leslier7/scopeboy/README.md

# scopeboy
Polished version of the ScopeBoy project started in ECE5730
