leslier7/scopeboy/board/RP2350_QFN80.step

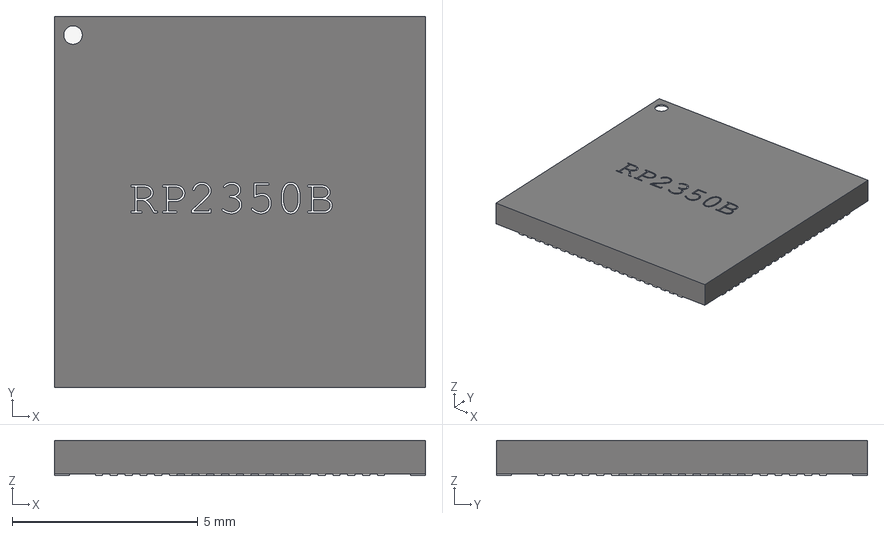
[picture p1: CAD file, 2026-02-20]
board/RP2350_QFN80.step
10.0 x 10.0 x 0.95 mm
