leslier7/scopeboy/board/scopeboy.kicad_pcb

## KiCad design board/scopeboy.kicad_pcb (2026-05-14)

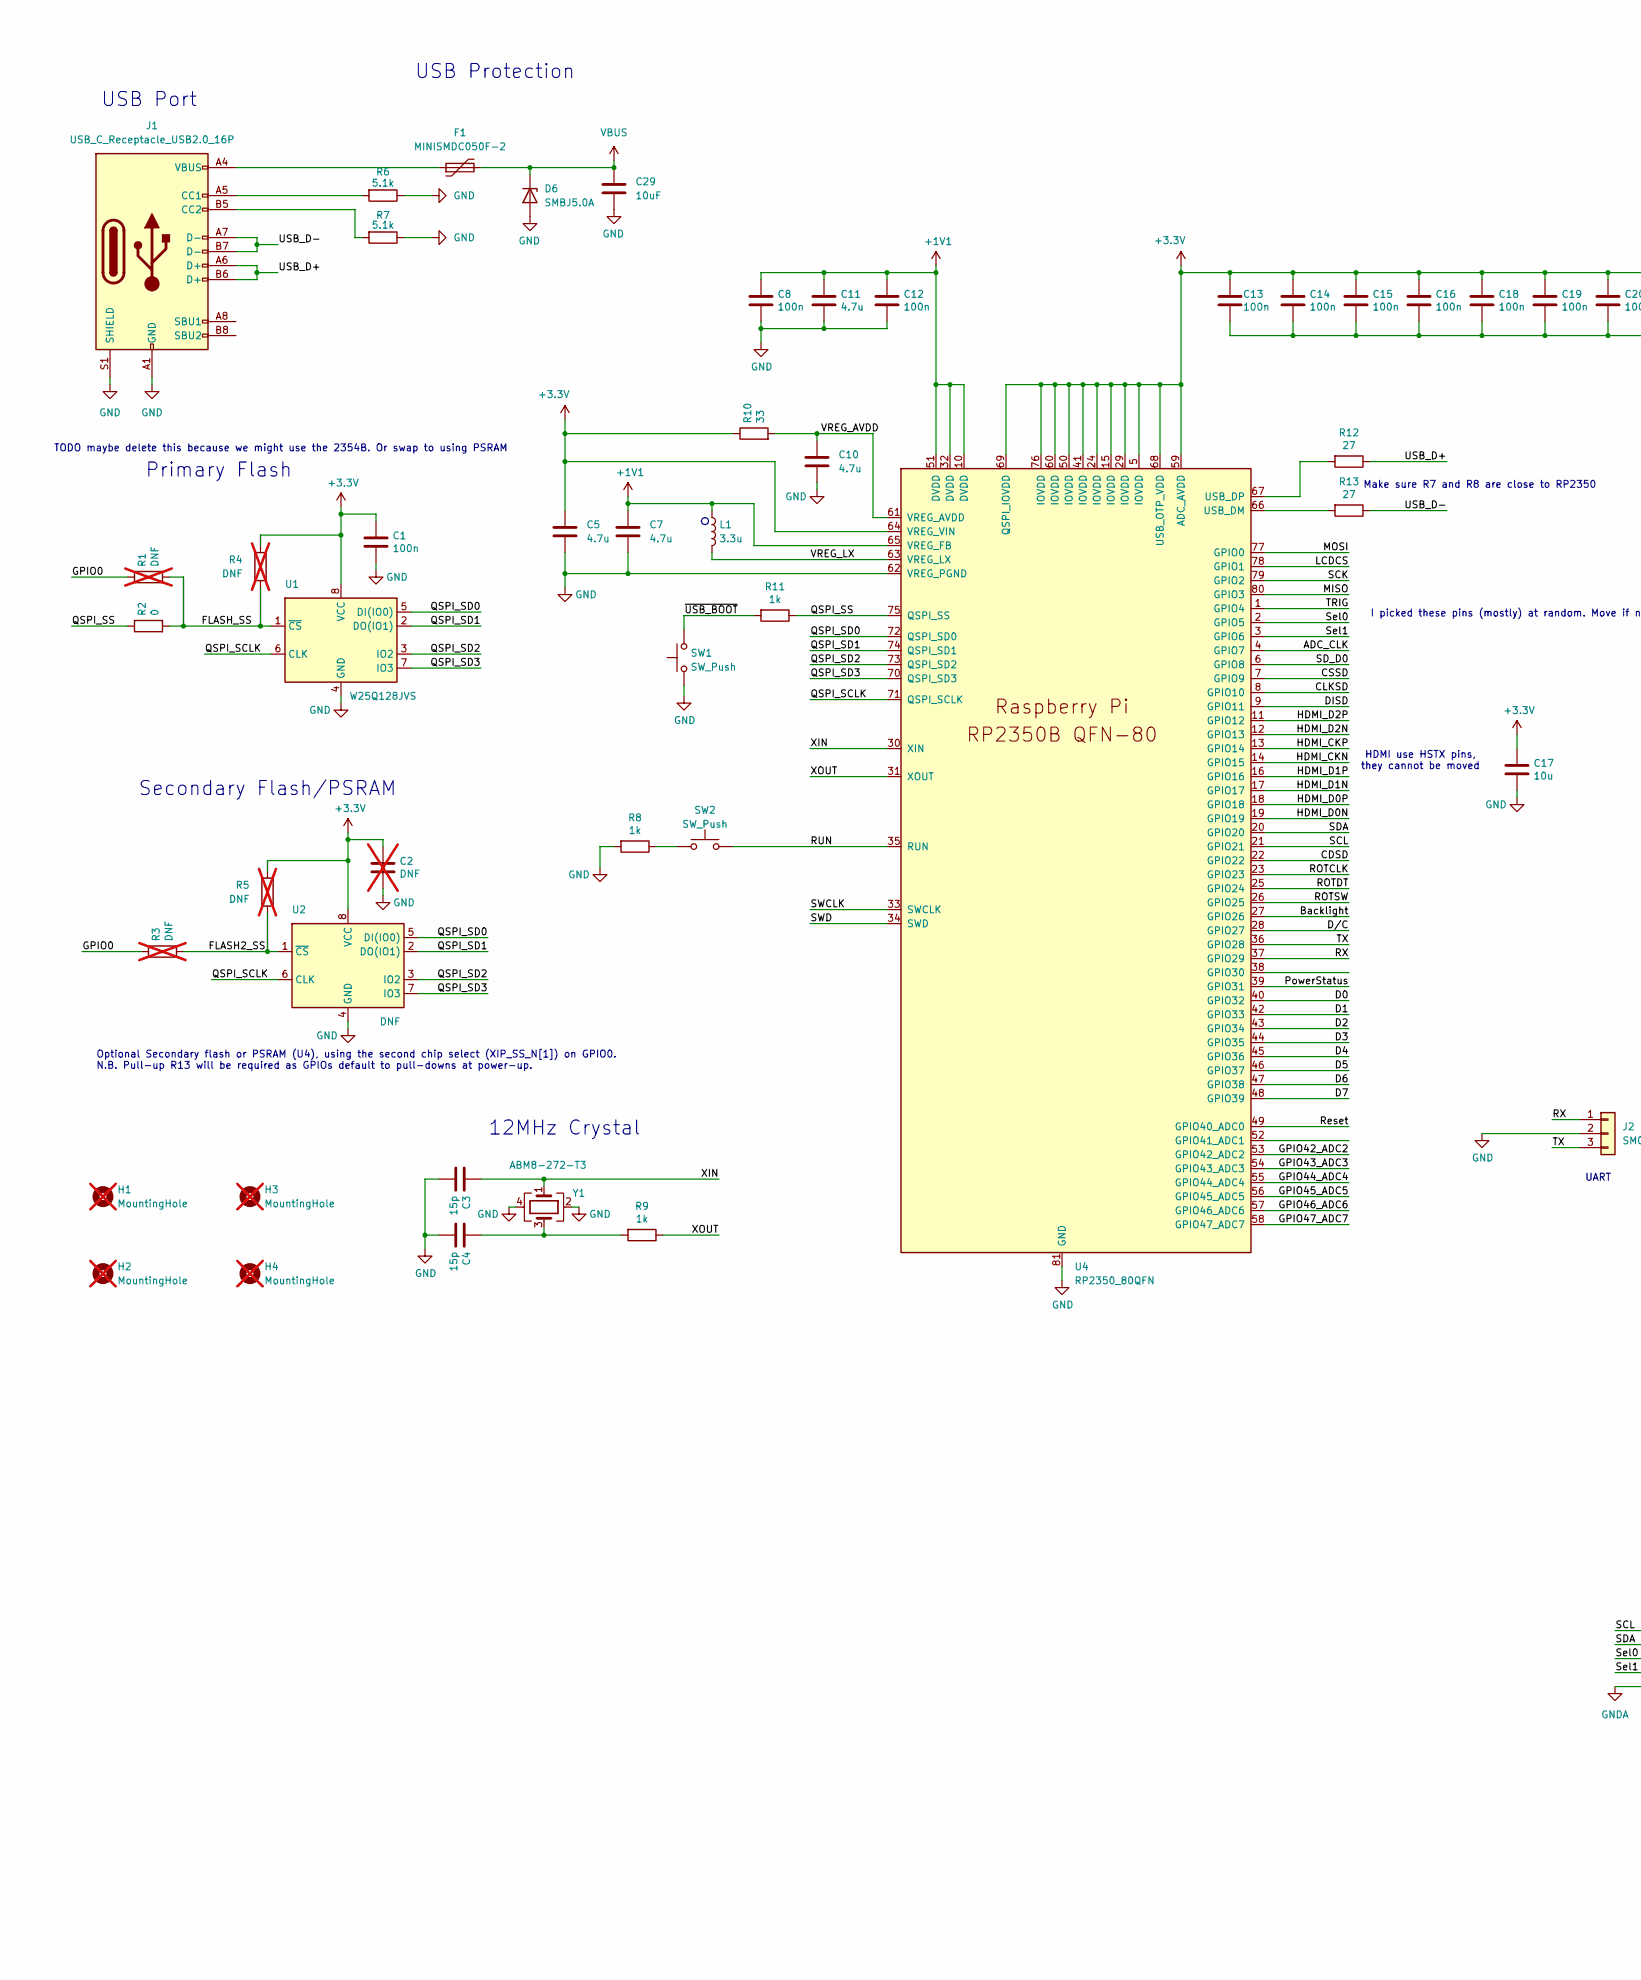
[picture p2: schematic scopeboy.kicad_sch, part in row 1, column 1]

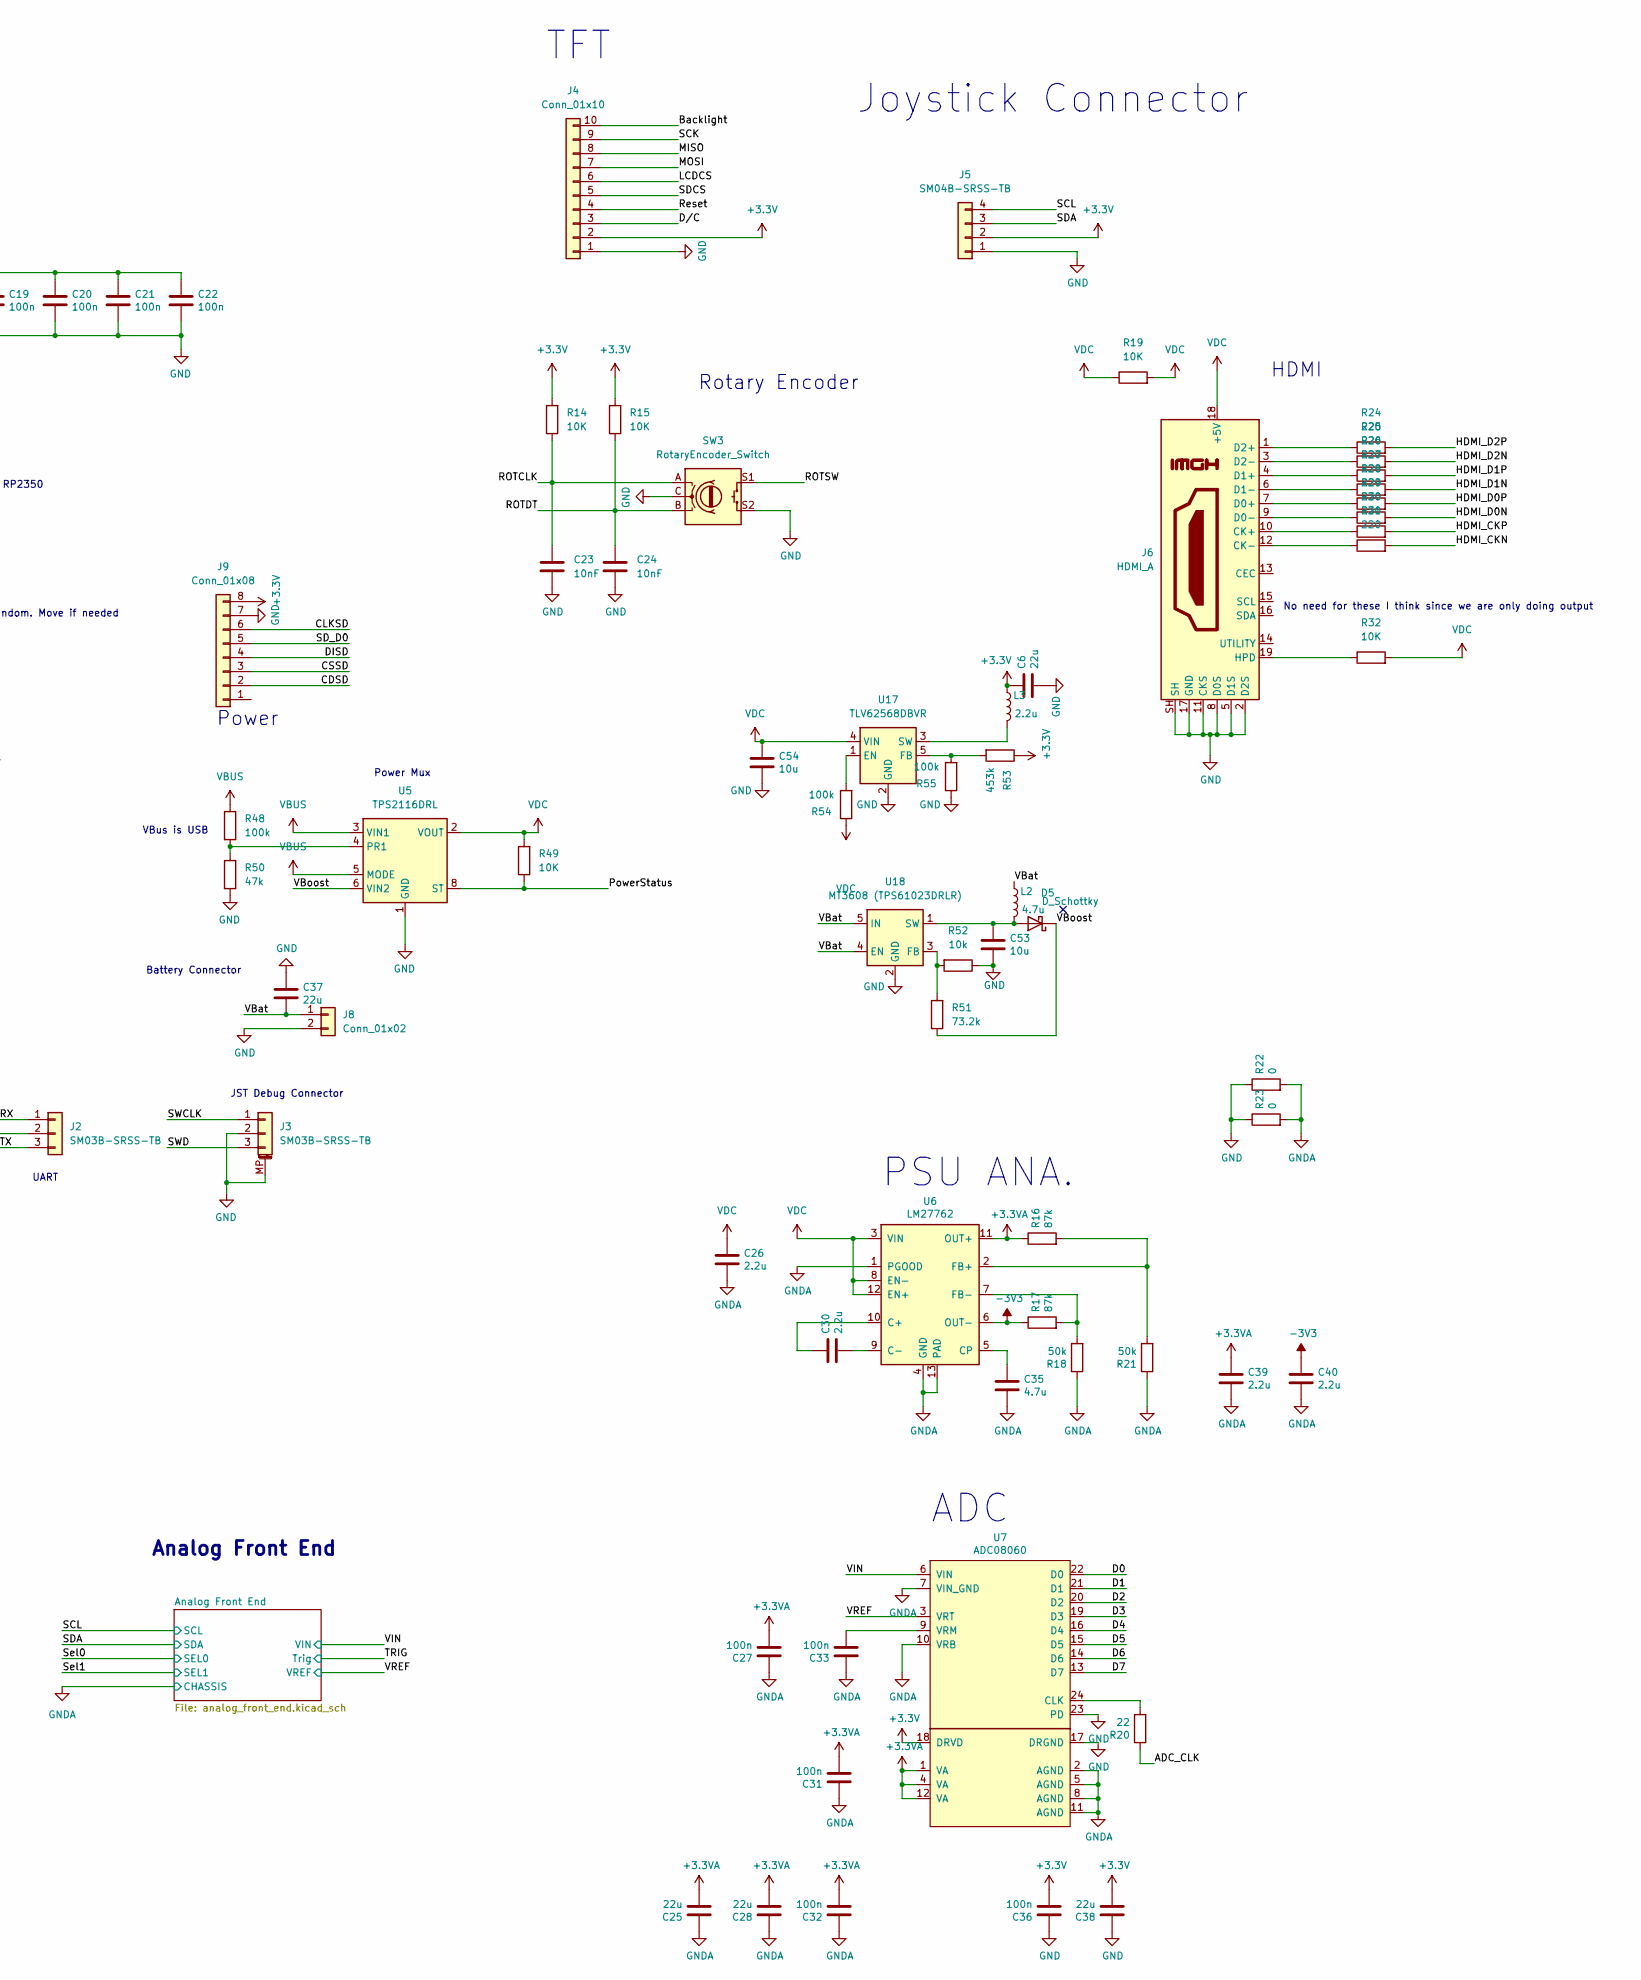
[picture p3: schematic scopeboy.kicad_sch, part in row 1, column 2]

Parts:
C1, C8, C12, C13, C14, C15, C16, C18, C19, C20, C21, C22: 100n; C_0402_1005Metric; MFR. Part # AC0402JRNPO9BN100
C2: DNF; C_0402_1005Metric; not fitted
C3, C4: 15p; C_0402_1005Metric; MFR. Part # GJM1555C1H150GB01D
C5, C7: 4.7u; C_0402_1005Metric_small_pads; MFR. Part # CL05A475MP5NRNC
C6, C37: 22u; C_0805_2012Metric; MFR. Part # CL21A226MQQNNNE
C10, C11: 4.7u; C_0402_1005Metric; MFR. Part # CL05A475MP5NRNC
C17, C53, C54: 10u; C_0805_2012Metric; MFR. Part # CL21A106KOQNNNE
C23, C24: 10nF; C_0603_1608Metric; MFR. Part # CL10B103KB8NNNC; LCSC Part # C1589
C25, C28, C38: 22u; C_0603_1608Metric; MFR. Part # CL10A226MQ8NRNC; LCSC Part # C59461
C26, C30, C39, C40: 2.2u; C_0603_1608Metric; MFR. Part # CL10A225KO8NNNC; LCSC Part # C23630
C27, C31, C32, C33, C36: 100n; C_0603_1608Metric; MFR. Part # CC0603KRX7R9BB104; LCSC Part # C14663
C29: 10uF; C_1206_3216Metric; MFR. Part # TMK316BJ106KL-T
C35: 4.7u; C_0603_1608Metric; MFR. Part # CL10A475KO8NNNC; LCSC Part # C19666
D5: D_Schottky; D_SMA; MFR. Part # SS14
D6: SMBJ5.0A; D_SMB; MFR. Part # SMBJ5.0A
F1: MINISMDC050F-2; Fuse_1812_4532Metric; MFR. Part # MINISMDC050F-2
H1, H2, H3, H4: MountingHole; MountingHole_3.2mm_M3_Pad_TopBottom; not fitted
J1: USB_C_Receptacle_USB2.0_16P; USB_C_Receptacle_GCT_USB4105-xx-A_16P_TopMnt_Horizontal; MFR. Part # USB4105-GF-A
J2: SM03B-SRSS-TB; JST_SH_SM03B-SRSS-TB_1x03-1MP_P1.00mm_Horizontal; MFR. Part # SM03B-SRSS-TB(LF)(SN); LCSC Part # C160403
J3: SM03B-SRSS-TB; JST_SH_SM03B-SRSS-TB_1x03-1MP_P1.00mm_Horizontal
J4: Conn_01x10; PinHeader_1x10_P2.54mm_Vertical
J5: SM04B-SRSS-TB; JST_SH_SM04B-SRSS-TB_1x04-1MP_P1.00mm_Horizontal; MFR. Part # SM04B-SRSS-TB(LF)(SN); LCSC Part # C160404
J6: HDMI_A; HDMI_A_Molex_208658-1001_Horizontal; MFR. Part # 2086581001
J8: Conn_01x02; JST_PH_S2B-PH-SM4-TB_1x02-1MP_P2.00mm_Horizontal; MFR. Part # S2B-PH-SM4-TB(LF)(SN)
J9: Conn_01x08; PinHeader_1x08_P2.54mm_Vertical
L1: 3.3u; L_pol_2016; MFR. Part # SRN4018TA-3R3M
L2: 4.7u; L_Bourns-SRN4018; MFR. Part # SRN4018TA-4R7M
L3: 2.2u; L_Bourns-SRN4018; MFR. Part # SRN4018-2R2M
R1, R3, R4, R5: DNF; R_0402_1005Metric; not fitted
R2: 0; R_0402_1005Metric; MFR. Part # RC0402JR-070RL
R6, R7: 5.1k; R_1206_3216Metric; MFR. Part # CRCW12065K10FKEA
R8, R9, R11: 1k; R_0402_1005Metric; MFR. Part # CRCW04021K00FKED
R10: 33; R_0402_1005Metric; MFR. Part # RC0402JR-0733RL
R12, R13: 27; R_0402_1005Metric; MFR. Part # RC0402JR-0727RL
R14, R15, R19, R32, R49: 10K; R_0603_1608Metric; MFR. Part # RC0603FR-0710KL
R16, R17: 87k; R_0603_1608Metric; MFR. Part # 0603WAF8202T5E; LCSC Part # C23254
R18, R21: 50k; R_0603_1608Metric; MFR. Part # 0603WAF1503T5E; LCSC Part # C22807
R20: 22; R_0603_1608Metric; MFR. Part # 0603WAF220JT5E; LCSC Part # C23345
R22, R23: 0; R_0603_1608Metric; MFR. Part # 0603WAF0000T5E; LCSC Part # C21189
R24, R25, R26, R27, R28, R29, R30, R31: 220; R_0603_1608Metric; MFR. Part # CRGCQ0603J220R
R48, R54, R55: 100k; R_0603_1608Metric; MFR. Part # RC0603FR-07100KL
R50: 47k; R_0603_1608Metric; MFR. Part # RC0603FR-0747KL
R51: 73.2k; R_0603_1608Metric; MFR. Part # RMCF0603FT73K2
R52: 10k; R_0603_1608Metric; MFR. Part # RC0603FR-0710KL
R53: 453k; R_0603_1608Metric; MFR. Part # CRCW0603453KFKEAC
SW1, SW2: SW_Push; SW_Push_1P1T_NO_Vertical_Wuerth_434133025816
SW3: RotaryEncoder_Switch; PEC11L4115FS0020; MFR. Part # PEC11L4115FS0020
U1: W25Q128JVS; SOIC-8_5.23x5.23mm_P1.27mm; MFR. Part # W25Q128JVS
U2: DNF; SOIC-8_5.23x5.23mm_P1.27mm
U4: RP2350_80QFN; RP2350-QFN-80-1EP_10x10_P0.4mm_EP3.4x3.4mm_ThermalVias; MFR. Part # RP2354B
U5: TPS2116DRL; SOT-583-8; MFR. Part # TPS2116DRLR
U6: LM27762; WSON-12-1EP_3x2mm_P0.5mm_EP1x2.65_ThermalVias; MFR. Part # LM27762DSSR; LCSC Part # C473398
U7: ADC08060; TSSOP-24_4.4x7.8mm_P0.65mm; MFR. Part # TI ADC08060CIMT/NOPB; LCSC Part # C701069
U17: TLV62568DBVR; SOT-23-5; MFR. Part # TLV62568DBVR
U18: MT3608 (TPS61023DRLR); SOT-23-6; MFR. Part # MT3608
Y1: ABM8-272-T3; Crystal_SMD_3225-4Pin_3.2x2.5mm; MFR. Part # ABM8-272-T3

Connections:
+1V1: C7.1, C8.1, C11.1, C12.1, L1.1, U4.10 (DVDD), U4.32 (DVDD), U4.51 (DVDD), U4.65 (VREG_FB)
+3.3V: C1.1, C2.1, C5.1, C6.1, C13.1, C14.1, C15.1, C16.1, C17.1, C18.1, C19.1, C20.1, C21.1, C22.1, C36.2, C38.2, J4.2, J5.2, J9.8, L3.1, R4.1, R5.1, R10.1, R14.2, R15.2, R53.1, U1.8 (VCC), U2.8 (VCC), U4.5 (IOVDD), U4.15 (IOVDD), U4.24 (IOVDD), U4.29 (IOVDD), U4.41 (IOVDD), U4.50 (IOVDD), U4.59 (ADC_AVDD), U4.60 (IOVDD), U4.64 (VREG_VIN), U4.68 (USB_OTP_VDD), U4.69 (QSPI_IOVDD), U4.76 (IOVDD), U7.18 (DRVD)
+3.3VA: C25.2, C27.2, C28.2, C31.2, C32.2, C39.1, R16.1, U6.11 (OUT+), U7.1 (VA), U7.4 (VA), U7.12 (VA); also elsewhere on the board
-3V3: C40.1, R17.1, U6.6 (OUT-); also elsewhere on the board
/ADC_CLK: R20.1, U4.4 (GPIO7)
/Backlight: J4.10, U4.27 (GPIO26)
/CDSD: J9.2, U4.22 (GPIO22)
/CLKSD: J9.6, U4.8 (GPIO10)
/CSSD: J9.3, U4.7 (GPIO9)
/D0: U4.40 (GPIO32), U7.22 (D0)
/D1: U4.42 (GPIO33), U7.21 (D1)
/D2: U4.43 (GPIO34), U7.20 (D2)
/D3: U4.44 (GPIO35), U7.19 (D3)
/D4: U4.45 (GPIO36), U7.16 (D4)
/D5: U4.46 (GPIO37), U7.15 (D5)
/D6: U4.47 (GPIO38), U7.14 (D6)
/D7: U4.48 (GPIO39), U7.13 (D7)
/DISD: J9.4, U4.9 (GPIO11)
/D/C: J4.3, U4.28 (GPIO27)
/FLASH2_SS: R3.2, R5.2, U2.1 (~CS)
/FLASH_SS: R1.2, R2.2, R4.2, U1.1 (~CS)
/GPIO0: R1.1, R3.1
/GPIO42_ADC2: U4.53 (GPIO42_ADC2)
/GPIO43_ADC3: U4.54 (GPIO43_ADC3)
/GPIO44_ADC4: U4.55 (GPIO44_ADC4)
/GPIO45_ADC5: U4.56 (GPIO45_ADC5)
/GPIO46_ADC6: U4.57 (GPIO46_ADC6)
/GPIO47_ADC7: U4.58 (GPIO47_ADC7)
/HDMI_CKN: R31.2, U4.14 (GPIO15)
/HDMI_CKP: R30.2, U4.13 (GPIO14)
/HDMI_D0N: R29.2, U4.19 (GPIO19)
/HDMI_D0P: R28.2, U4.18 (GPIO18)
/HDMI_D1N: R27.2, U4.17 (GPIO17)
/HDMI_D1P: R26.2, U4.16 (GPIO16)
/HDMI_D2N: R25.2, U4.12 (GPIO13)
/HDMI_D2P: R24.2, U4.11 (GPIO12)
/LCDCS: J4.6, U4.78 (GPIO1)
/MISO: J4.8, U4.80 (GPIO3)
/MOSI: J4.7, U4.77 (GPIO0)
/PowerStatus: R49.1, U4.39 (GPIO31), U5.8 (ST)
/QSPI_SCLK: U1.6 (CLK), U2.6 (CLK), U4.71 (QSPI_SCLK)
/QSPI_SD0: U1.5 (DI(IO0)), U2.5 (DI(IO0)), U4.72 (QSPI_SD0)
/QSPI_SD1: U1.2 (DO(IO1)), U2.2 (DO(IO1)), U4.74 (QSPI_SD1)
/QSPI_SD2: U1.3 (IO2), U2.3 (IO2), U4.73 (QSPI_SD2)
/QSPI_SD3: U1.7 (IO3), U2.7 (IO3), U4.70 (QSPI_SD3)
/QSPI_SS: R2.1, R11.1, U4.75 (QSPI_SS)
/ROTCLK: C23.1, R14.1, SW3.A, U4.23 (GPIO23)
/ROTDT: C24.1, R15.1, SW3.B, U4.25 (GPIO24)
/ROTSW: SW3.S1, U4.26 (GPIO25)
/RUN: SW2.2, U4.35 (RUN)
/RX: J2.1, U4.37 (GPIO29)
/Reset: J4.4, U4.49 (GPIO40_ADC0)
/SCK: J4.9, U4.79 (GPIO2)
/SCL: J5.4, U4.21 (GPIO21); also elsewhere on the board
/SDA: J5.3, U4.20 (GPIO20); also elsewhere on the board
/SDCS: J4.5
/SD_D0: J9.5, U4.6 (GPIO8)
/SWCLK: J3.1, U4.33 (SWCLK)
/SWD: J3.3, U4.34 (SWD)
/Sel0: U4.2 (GPIO5); also elsewhere on the board
/Sel1: U4.3 (GPIO6); also elsewhere on the board
/TRIG: U4.1 (GPIO4); also elsewhere on the board
/TX: J2.3, U4.36 (GPIO28)
/USB_D+: J1.A6 (D+), J1.B6 (D+), R12.1
/USB_D-: J1.A7 (D-), J1.B7 (D-), R13.1
/VBat: C37.2, J8.1, L2.1, U18.4 (EN), U18.5 (IN)
/VBoost: D5.1 (K), R51.1, U5.6 (VIN2)
/VIN: U7.6 (VIN); also elsewhere on the board
/VREF: U7.3 (VRT); also elsewhere on the board
/VREG_AVDD: C10.1, R10.2, U4.61 (VREG_AVDD)
/VREG_LX: L1.2, U4.63 (VREG_LX)
/XIN: C3.1, U4.30 (XIN), Y1.1
/XOUT: R9.1, U4.31 (XOUT)
/~USB_BOOT: R11.2, SW1.2
GND: C1.2, C2.2, C3.2, C4.2, C5.2, C6.2, C7.2, C8.2, C10.2, C11.2, C12.2, C13.2, C14.2, C15.2, C16.2, C17.2, C18.2, C19.2, C20.2, C21.2, C22.2, C23.2, C24.2, C29.1, C36.1, C37.1, C38.1, C53.2, C54.2, D6.2 (A), J1.A1 (GND), J1.A12 (GND), J1.B1 (GND), J1.B12 (GND), J1.S1 (SHIELD), J2.2, J3.2, J3.MP (MountPin), J4.1, J5.1, J6.2 (D2S), J6.5 (D1S), J6.8 (D0S), J6.11 (CKS), J6.17 (GND), J6.SH, J8.2, J9.7, R6.1, R7.1, R8.2, R22.1, R23.1, R50.2, R52.1, R55.1, SW1.1, SW3.C, SW3.S2, U1.4 (GND), U2.4 (GND), U4.62 (VREG_PGND), U4.81 (GND), U5.1 (GND), U7.17 (DRGND), U7.23 (PD), U17.2 (GND), U18.2 (GND), Y1.2, Y1.4
GNDA: C25.1, C26.2, C27.1, C28.1, C31.1, C32.1, C33.1, C35.2, C39.2, C40.2, R18.1, R21.1, R22.2, R23.2, U6.1 (PGOOD), U6.4 (GND), U6.13 (PAD), U7.2 (AGND), U7.5 (AGND), U7.7 (VIN_GND), U7.8 (AGND), U7.10 (VRB), U7.11 (AGND); also elsewhere on the board
unnamed: C4.1, R9.2, Y1.3
unnamed: C53.1, D5.2 (A), L2.2, U18.1 (SW)
unnamed: F1.1, J1.A4 (VBUS), J1.A9 (VBUS), J1.B4 (VBUS), J1.B9 (VBUS)
unnamed: J1.A5 (CC1), R6.2
unnamed: J1.B5 (CC2), R7.2
unnamed: J6.10 (CK+), R30.1
unnamed: J6.12 (CK-), R31.1
unnamed: J6.7 (D0+), R28.1
unnamed: J6.9 (D0-), R29.1
unnamed: J6.4 (D1+), R26.1
unnamed: J6.6 (D1-), R27.1
unnamed: J6.1 (D2+), R24.1
unnamed: J6.3 (D2-), R25.1
unnamed: J6.19 (HPD), R32.1
unnamed: R8.1, SW2.1
unnamed: R13.2, U4.66 (USB_DM)
unnamed: R12.2, U4.67 (USB_DP)
unnamed: R48.2, R50.1, U5.4 (PR1)
unnamed: C30.1, U6.10 (C+)
unnamed: C30.2, U6.9 (C-)
unnamed: C35.1, U6.5 (CP)
unnamed: R16.2, R21.2, U6.2 (FB+)
unnamed: R17.2, R18.2, U6.7 (FB-)
unnamed: R20.2, U7.24 (CLK)
unnamed: C33.2, U7.9 (VRM)
unnamed: R54.2, U17.1 (EN)
unnamed: R53.2, R55.2, U17.5 (FB)
unnamed: L3.2, U17.3 (SW)
unnamed: R51.2, R52.2, U18.3 (FB)
VBUS: C29.2, D6.1 (K), F1.2, R48.1, U5.3 (VIN1), U5.5 (MODE)
VDC: C26.1, C54.1, J6.18 (+5V), R19.1, R19.2, R32.2, R49.2, R54.1, U5.2 (VOUT), U5.7 (VOUT), U6.3 (VIN), U6.8 (EN-), U6.12 (EN+), U17.4 (VIN)

Notes on the sheet:
Optional Secondary flash or PSRAM (U4), using the second chip select (XIP_SS_N[1]) on GPIO0. N.B. Pull-up R13 will be required as GPIOs default to pull-downs at power-up.
Rotary Encoder
12MHz Crystal
Power Mux
I picked these pins (mostly) at random. Move if needed
ADC
PSU ANA.
Joystick Connector
Primary Flash
USB Protection
Battery Connector
No need for these I think since we are only doing output
TFT
HDMI use HSTX pins, they cannot be moved
JST Debug Connector
Make sure R7 and R8 are close to RP2350
Analog Front End
Secondary Flash/PSRAM
TODO maybe delete this because we might use the 2354B. Or swap to using PSRAM
VBus is USB
UART
USB Port
Power
HDMI

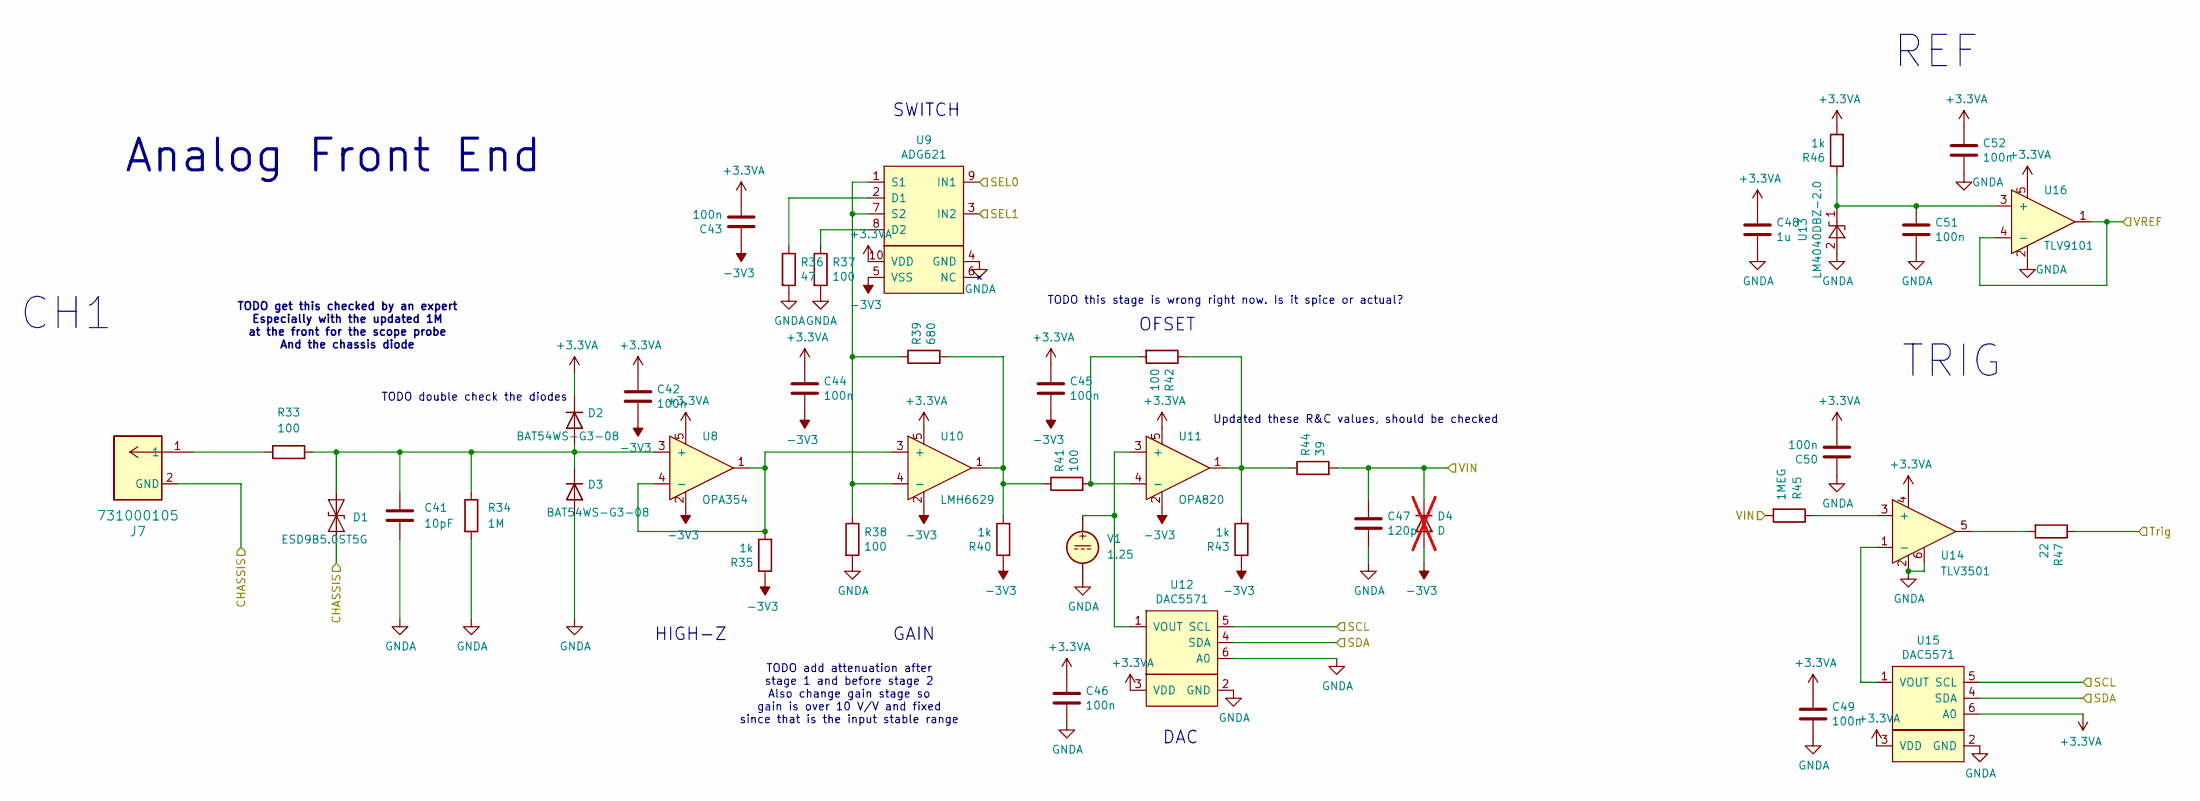
[picture p4: schematic analog_front_end.kicad_sch]

Parts:
C41: 10pF; C_0603_1608Metric; MFR. Part # C0603C100J5GACTU
C42, C43, C44, C45, C46, C49, C50, C51, C52: 100n; C_0603_1608Metric; MFR. Part # CC0603KRX7R9BB104; LCSC Part # C14663
C47: 120p; C_0603_1608Metric; MFR. Part # FN18X104K160PSG
C48: 1u; C_0603_1608Metric; MFR. Part # CL10A105KB8NNNC; LCSC Part # C15849
D1: ESD9B5.0ST5G; D_SOD-923; MFR. Part # ESD9B5.0ST5G
D2, D3: BAT54WS-G3-08; D_0603_1608Metric; MFR. Part # BAT54WS-E3-08
D4: D; D_0603_1608Metric; not fitted
J7: 731000105; CONN_73100-0105_MOL; MFR. Part # 731000105
R33: 100; R_0603_1608Metric; MFR. Part # ERJ-3EKF1000V
R34: 1M; R_0603_1608Metric; MFR. Part # RC0603FR-071ML
R35, R40, R43, R46: 1k; R_0603_1608Metric; MFR. Part # 0603WAF1001T5E; LCSC Part # C21190
R36: 47; R_0603_1608Metric; MFR. Part # 0603WAF470JT5E; LCSC Part # C23182
R37, R38, R41, R42: 100; R_0603_1608Metric; MFR. Part # ERJ-3EKF1000V; LCSC Part # C22775
R39: 680; R_0603_1608Metric; MFR. Part # 0603WAF6801T5E; LCSC Part # C23212
R44: 39; R_0603_1608Metric; MFR. Part # 0603WAF1000T5E
R45: 1MEG; R_0603_1608Metric; MFR. Part # ERJ3EKF1004V; LCSC Part # C193390
R47: 22; R_0603_1608Metric; MFR. Part # 0603WAF220JT5E; LCSC Part # C23345
U8: OPA354; SOT-23-5; MFR. Part # OPA354AIDBVR; LCSC Part # C36384
U9: ADG621; MSOP-10_3x3mm_P0.5mm; MFR. Part # ADG621BRMZ; LCSC Part # C208597
U10: LMH6629; SOT-23-5; MFR. Part # LMH6629MFX/NOPB; LCSC Part # C206003
U11: OPA820; SOT-23-5; MFR. Part # OPA830IDBVR; LCSC Part # C2058414
U12, U15: DAC5571; SOT-23-6; MFR. Part # DAC5571IDBVT; LCSC Part # C24061
U13: LM4040DBZ-2.0; SOT-23; MFR. Part # LM4040A20IDBZR; LCSC Part # C127070
U14: TLV3501; SOT-23-6; MFR. Part # TLV3501AIDBVT; LCSC Part # C193413
U16: TLV9101; SOT-23-5; MFR. Part # TLV9101IDBVR; LCSC Part # C4368903
V1: 1.25

Connections:
+3.3VA: C42.1, C43.2, C44.1, C45.1, C46.1, C48.1, C49.1, C50.2, C52.1, D2.1 (K), R46.2, U8.5, U9.10 (VDD), U10.5, U11.5, U12.3 (VDD), U14.4, U15.3 (VDD), U15.6 (A0), U16.5; also elsewhere on the board
-3V3: C42.2, C43.1, C44.2, C45.2, D4.2 (A), R35.1, R40.1, R43.1, U8.2, U9.5 (VSS), U10.2, U11.2; also elsewhere on the board
/SCL: U12.5 (SCL), U15.5 (SCL); also elsewhere on the board
/SDA: U12.4 (SDA), U15.4 (SDA); also elsewhere on the board
/Sel0: U9.9 (IN1); also elsewhere on the board
/Sel1: U9.3 (IN2); also elsewhere on the board
/TRIG: R47.1; also elsewhere on the board
/VIN: C47.1, D4.1 (K), R44.2, R45.2; also elsewhere on the board
/VREF: U16.1, U16.4 (-); also elsewhere on the board
GNDA: C41.2, C46.2, C47.2, C48.2, C49.2, C50.1, C51.2, C52.2, D1.2 (A2), D3.2 (A), J7.2 (GND), R34.2, R36.2, R37.2, R38.2, U9.4 (GND), U12.2 (GND), U12.6 (A0), U13.2 (A), U14.2, U14.6, U15.2 (GND), U16.2, V1.2; also elsewhere on the board
unnamed: C41.1, D1.1 (A1), D2.2 (A), D3.1 (K), R33.2, R34.1, U8.3 (+)
unnamed: J7.1, R33.1
unnamed: R39.2, R40.2, R41.1, U10.1
unnamed: R42.1, R43.2, R44.1, U11.1
unnamed: R47.2, U14.5
unnamed: R36.1, U9.2 (D1)
unnamed: R37.1, U9.8 (D2)
unnamed: R35.2, U8.1, U8.4 (-), U10.3 (+)
unnamed: R38.1, R39.1, U9.1 (S1), U9.7 (S2), U10.4 (-)
unnamed: U11.3 (+), U12.1 (VOUT), V1.1
unnamed: R41.2, R42.2, U11.4 (-)
unnamed: C51.1, R46.1, U13.1 (K), U16.3 (+)
unnamed: R45.1, U14.3 (+)
unnamed: U14.1 (-), U15.1 (VOUT)

Notes on the sheet:
TODO this stage is wrong right now. Is it spice or actual?
DAC
TODO add attenuation after stage 1 and before stage 2 Also change gain stage so gain is over 10 V/V and fixed since that is the input stable range
GAIN
REF
SWITCH
TODO get this checked by an expert Especially with the updated 1M at the front for the scope probe And the chassis diode
Updated these R&C values, should be checked
HIGH-Z
TODO double check the diodes
TRIG
CH1
OFSET
Analog Front End

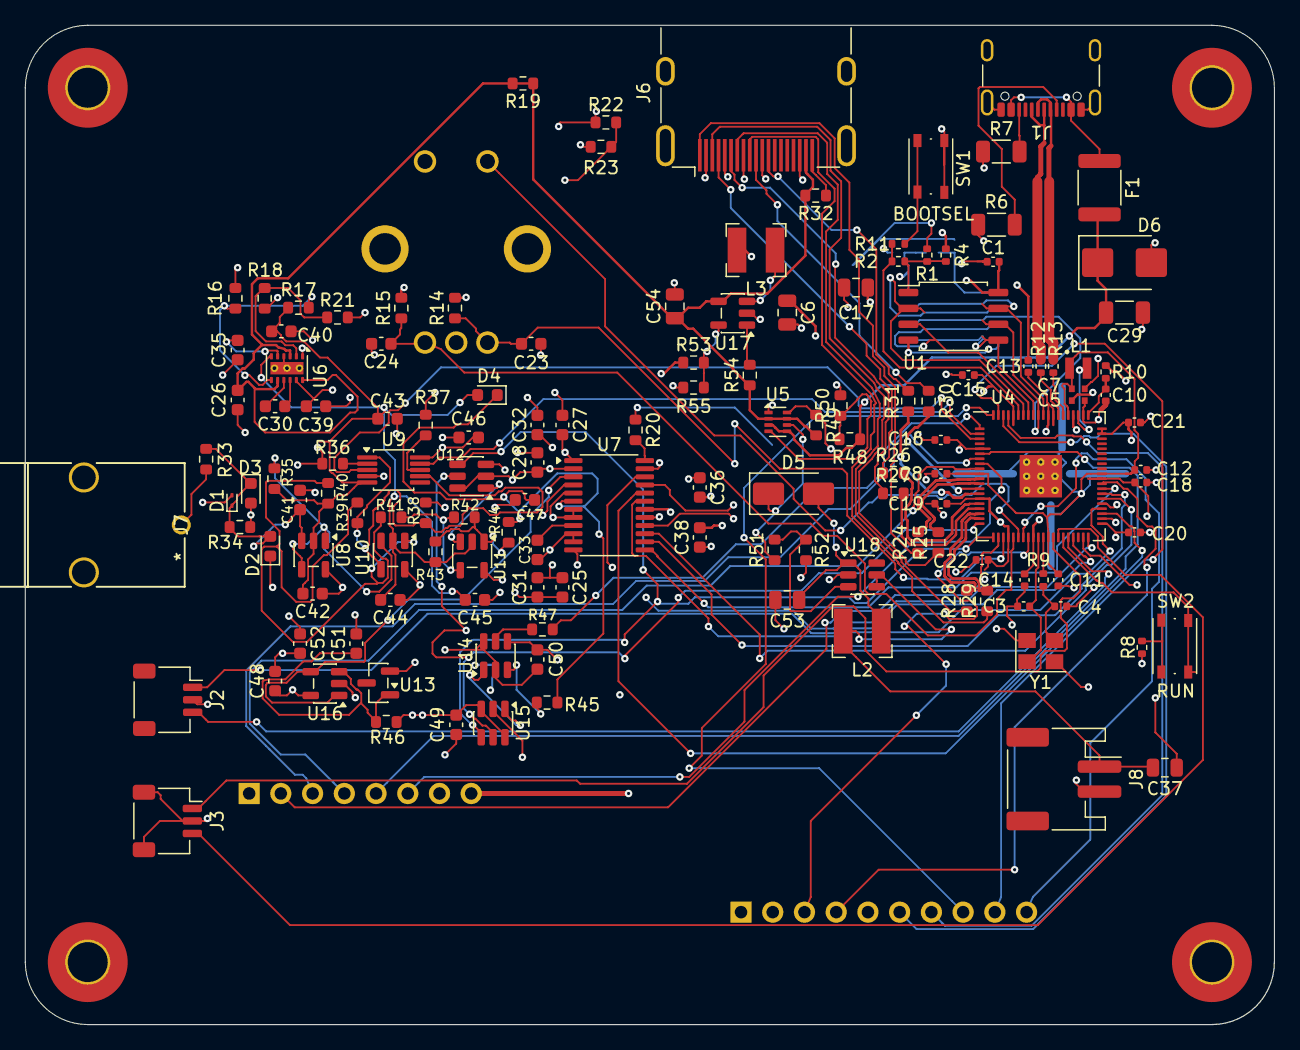
[picture p5: board scopeboy.kicad_pcb from above]

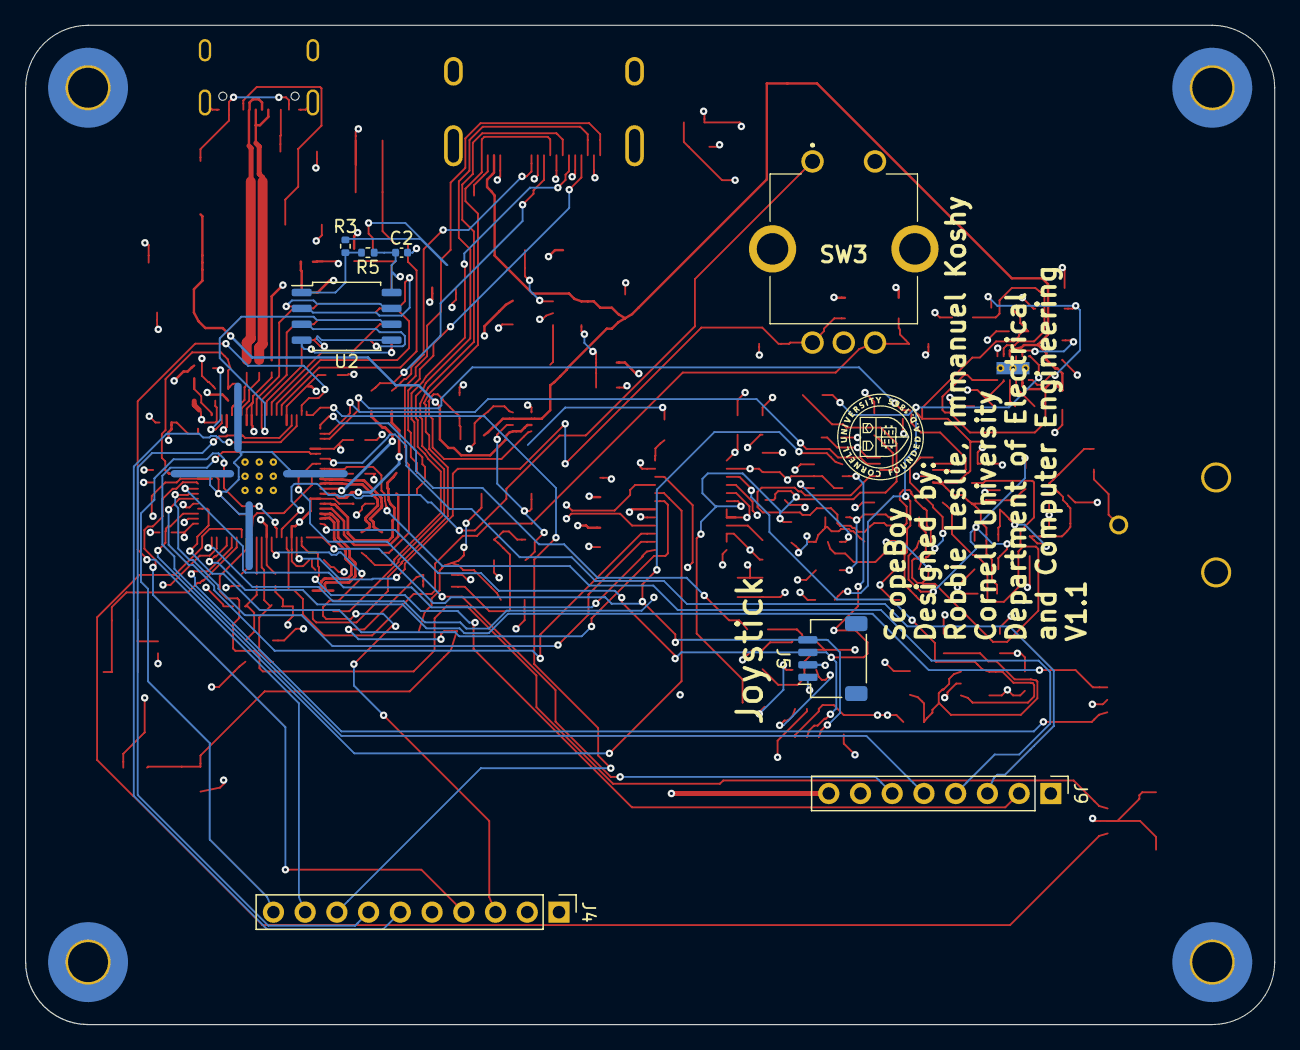
[picture p6: board scopeboy.kicad_pcb from below]

Board: 4 copper layers, 100.0 x 80.0 mm, 151 parts (8 on the bottom side), 114 nets.
