leslier7/scopeboy/(commit log)

2026-02-20 Minimal RP2350B board
    [RP2350_QFN80.step, scopeboy.kicad_pcb, scopeboy.kicad_sch]
2026-02-27 Continued schematic moving from old version to new version
    [scopeboy.kicad_sch]
2026-03-04 Fixed MFR label and added more TOOD
    [scopeboy.kicad_sch]
2026-03-06 More TODO notes and swaped ref op amp
    [scopeboy.kicad_sch]
2026-03-06 Added TODO for 5V charge pump
    [scopeboy.kicad_sch]
2026-03-06 HDMI to HSTX GPIO pins, and more TODOs
    [scopeboy.kicad_sch]
2026-03-13 Added spice circuit models
2026-03-13 Working on simulation for front end
    [analog_front_end.kicad_sch, analog_front_end_sim.kicad_sch, scopeboy.kicad_sch]
2026-03-19 Got first version of front end sim working
    [analog_front_end_sim.kicad_sch, stage_3_sim.kicad_sch]
2026-03-20 More work on front end circuit, and GPIO connections
    [analog_front_end.kicad_sch, analog_front_end_sim.kicad_sch, scopeboy.kicad_sch]
2026-04-17 All components in layout
    [analog_front_end.kicad_sch, scopeboy.kicad_pcb, scopeboy.kicad_sch]
2026-04-17 Positioned boards at same place
    [scopeboy.kicad_pcb]
2026-04-17 Replaced copper with vias
    [scopeboy.kicad_pcb]
2026-04-17 Started placement
    [scopeboy.kicad_pcb]
2026-04-17 New merge placemetn
    [scopeboy.kicad_pcb]
2026-04-17 Updated trig, sel0, sel1 pins
    [scopeboy.kicad_pcb, scopeboy.kicad_sch]
2026-04-17 Added battery JST connector
    [analog_front_end.kicad_sch, scopeboy.kicad_pcb, scopeboy.kicad_sch]
2026-04-19 Added power mux and USB protection
    [analog_front_end.kicad_sch, scopeboy.kicad_pcb, scopeboy.kicad_sch]
2026-04-20 Updated board with new power system
    [scopeboy.kicad_pcb, scopeboy.kicad_sch]
2026-04-20 Converted layer to power
    [scopeboy.kicad_pcb]
2026-04-20 Updated the board stackup
    [scopeboy.kicad_pcb, scopeboy.kicad_sch]
2026-04-20 Removed TODO comments
    [scopeboy.kicad_sch]
2026-05-11 Production version of board
    [analog_front_end.kicad_sch, scopeboy.kicad_pcb, scopeboy.kicad_sch]
2026-05-14 Fixing reset on TFT
    [scopeboy.kicad_pcb, scopeboy.kicad_sch]
2026-05-14 Fixed joystick qwiic connector bug
    [scopeboy.kicad_pcb, scopeboy.kicad_sch]
2026-05-14 Started work on fixing PCB bugs
    [analog_front_end.kicad_sch, scopeboy.kicad_pcb, scopeboy.kicad_sch]
